batkay/CapstonePCB/nrfMain.step

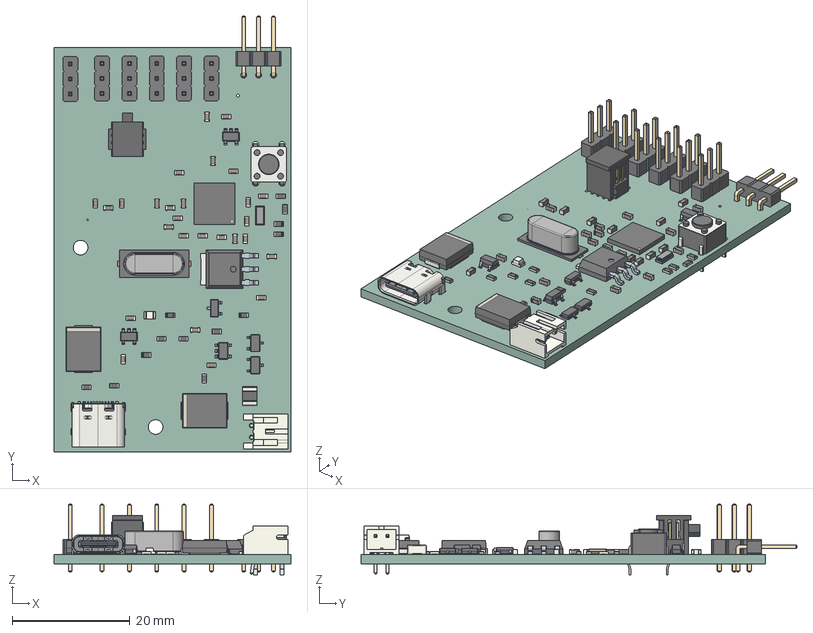
[picture p1: CAD file, 2025-03-10]
nrfMain.step
40.2 x 74.1 x 12.0 mm
R_0603_1608Metric x 13
Fuse_1210_3225Metric
PinHeader_1x03_P254mm_Vertical x 6
C_0603_1608Metric x 25
L_0603_1608Metric x 2
USB_C_Receptacle_16P_TopMnt_Horizontal_GCT_USB4105-xx-A
SOT_23_5 x 3
SW_PUSH_6mm
CQ assembly
SOT_23
TSOT_23 x 2
LED_0805_2012Metric
D_SMC x 2
Crystal_SMD_HC49-SD
FTSH-105-01-F-DV-K-P-TR
Nordic_AQFN-73-1EP_7x7mm_P0.5mm
JST_S2B_PH_K
Crystal_SMD_3215-2Pin_3.2x1.5mm
PinHeader_1x03_P254mm_Horizontal
nrfMain_PCB
