batkay/CapstonePCB/nrfMain.kicad_pcb

## KiCad design nrfMain.kicad_pcb (2025-03-14)

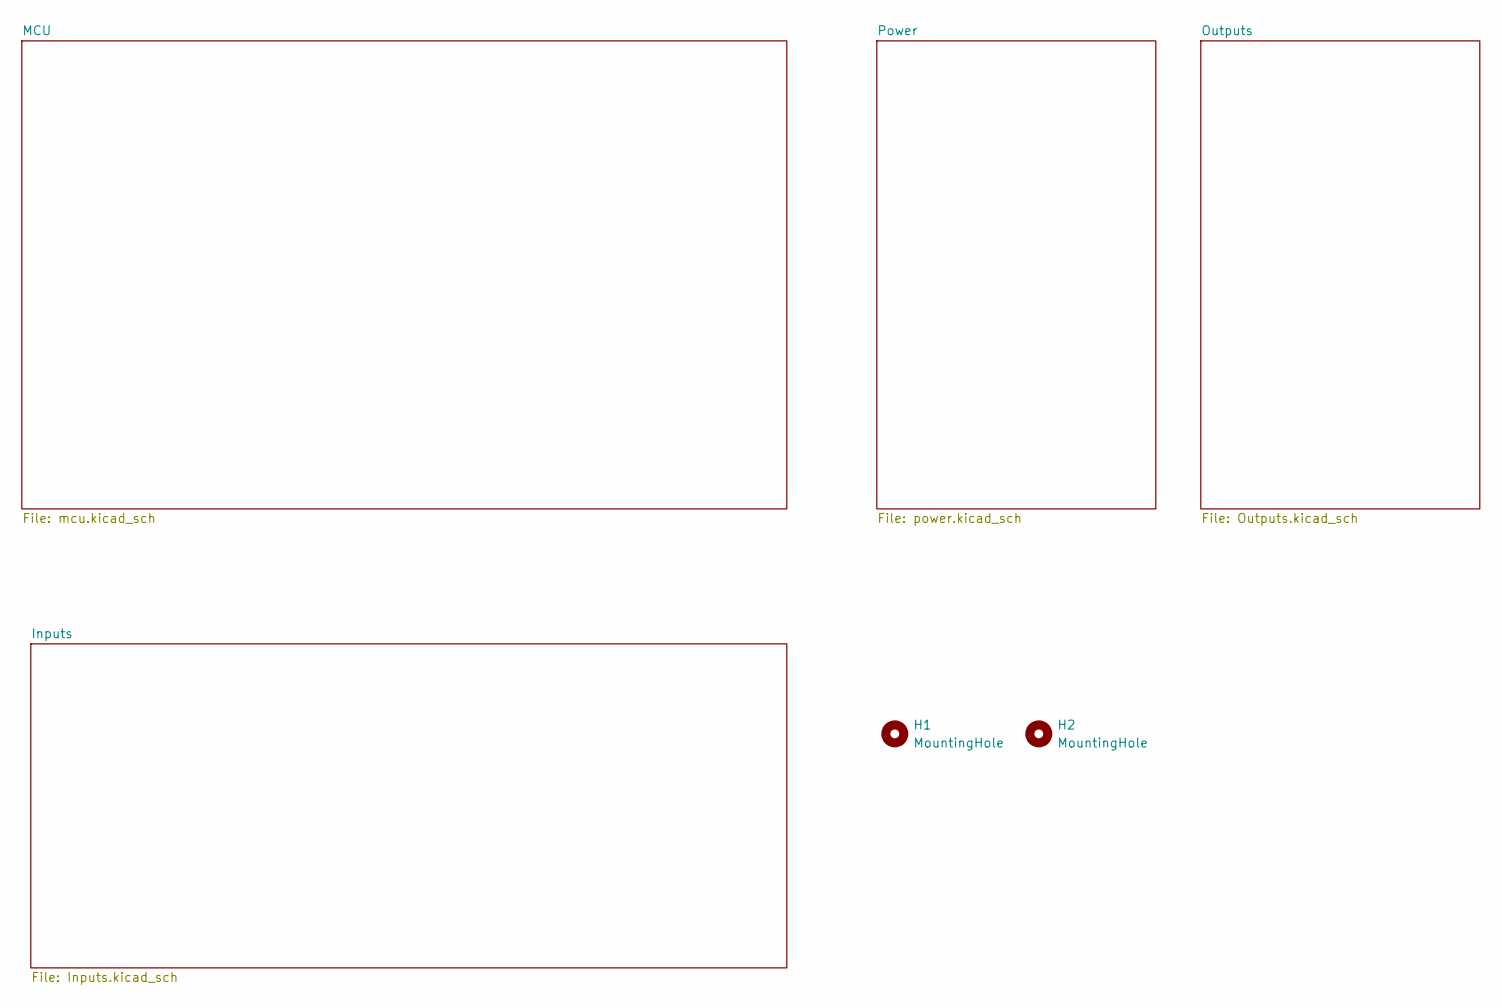
[picture p2: schematic nrfMain.kicad_sch]

Parts:
H1, H2: MountingHole; MountingHole_2.5mm

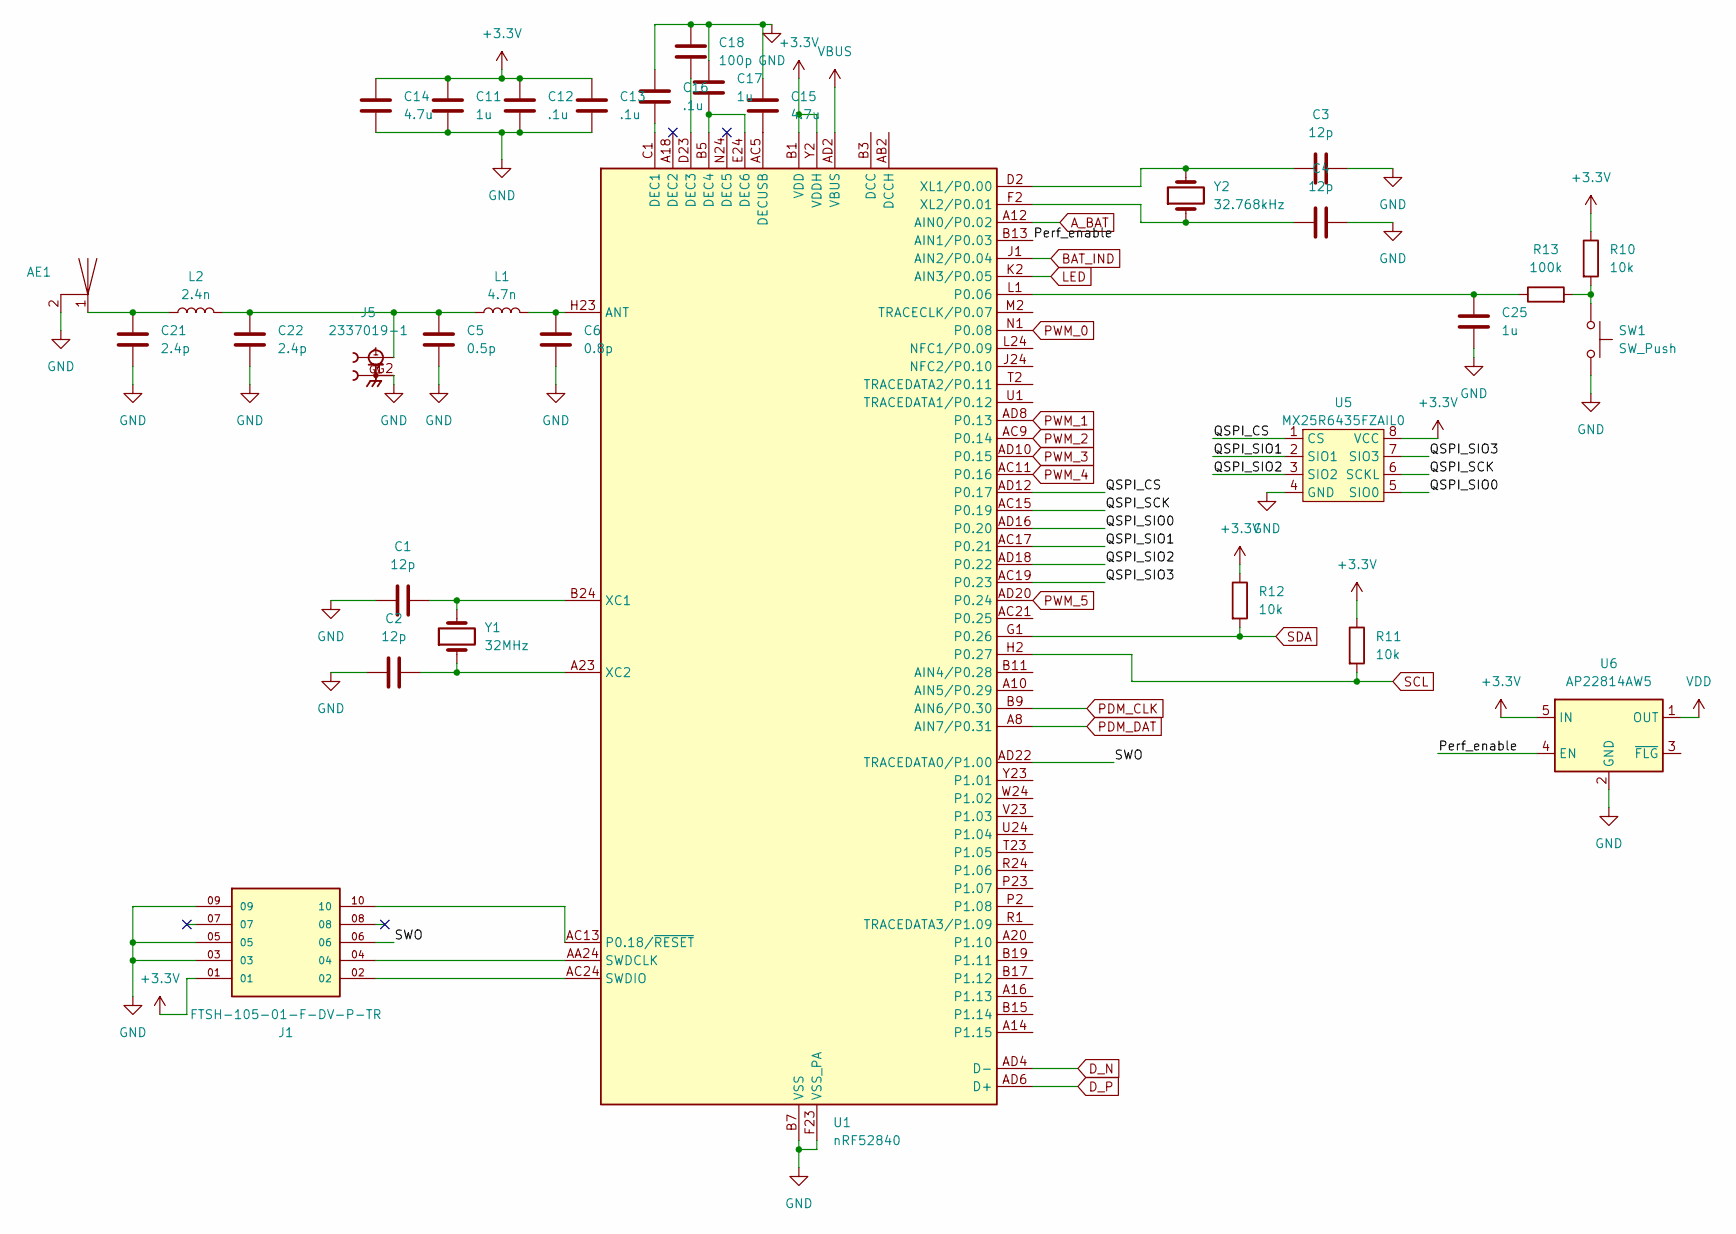
[picture p3: schematic mcu.kicad_sch]

Parts:
AE1: Trace Antenna
C1, C2, C3, C4: 12p; C_0603_1608Metric; MPN C107034; LCSC PN C107034
C5: 0.5p; C_0603_1608Metric; MPN C162254; LCSC PN C162254
C6: 0.8p; C_0603_1608Metric; MPN C907996; LCSC PN C907996
C11, C17, C25: 1u; C_0603_1608Metric; MPN C15849; LCSC PN C15849
C12, C13, C16: .1u; C_0603_1608Metric; MPN C14663; LCSC PN C14663
C14, C15: 4.7u; C_0603_1608Metric; MPN C19666; LCSC PN C19666
C18: 100p; C_0603_1608Metric; MPN C14665; LCSC PN C14665
C21, C22: 2.4p; C_0603_1608Metric; MPN C710896; LCSC PN C710896
J1: FTSH-105-01-F-DV-P-TR; SAMTEC_FTSH-105-01-F-DV-P-TR; PARTREV R; LCSC PN C5136979
J5: 2337019-1; TE_2337019-1; PARTREV A4
L1: 4.7n; L_0603_1608Metric; MPN C98078; LCSC PN C98078
L2: 2.4n; L_0603_1608Metric; MPN C2042508; LCSC PN C2042508
R10, R11, R12: 10k; R_0603_1608Metric; MPN C98220; LCSC PN C98220
R13: 100k; R_0603_1608Metric; MPN C14675; LCSC PN C14675
SW1: SW_Push; SW_PUSH_6mm; LCSC PN C393938
U1: nRF52840; Nordic_AQFN-73-1EP_7x7mm_P0.5mm; Part Number NRF52840-QIAA-R; LCSC PN C190794
U5: MX25R6435FZAIL0; WSON-8-1EP_4x4mm_P0.8mm_EP1.98x3mm; Part Number MX25R6435FZAIL0; LCSC PN C2802847
U6: AP22814AW5; SOT-23-5; MPN C2680321; LCSC PN C2680321
Y1: 32MHz; Crystal_SMD_HC49-SD; Part Number HY32M49SSMDOB2R20; LCSC PN C5265796
Y2: 32.768kHz; Crystal_SMD_3215-2Pin_3.2x1.5mm; Part Number Q13FC13500004; LCSC PN C32346

Connections:
+3.3V: C11.1, C12.1, C13.1, C14.1, J1.01, R10.1, R11.1, R12.1, U1.A22 (VDD), U1.AD14 (VDD), U1.AD23 (VDD), U1.B1 (VDD), U1.W1 (VDD), U1.Y2 (VDDH), U5.8 (VCC), U6.5 (IN); also elsewhere on the board
/MCU/Perf_enable: U1.B13 (AIN1/P0.03), U6.4 (EN)
/MCU/QSPI_CS: U1.AD12 (P0.17), U5.1 (CS)
/MCU/QSPI_SCK: U1.AC15 (P0.19), U5.6 (SCKL)
/MCU/QSPI_SIO0: U1.AD16 (P0.20), U5.5 (SIO0)
/MCU/QSPI_SIO1: U1.AC17 (P0.21), U5.2 (SIO1)
/MCU/QSPI_SIO2: U1.AD18 (P0.22), U5.3 (SIO2)
/MCU/QSPI_SIO3: U1.AC19 (P0.23), U5.7 (SIO3)
/MCU/SWO: J1.06, U1.AD22 (TRACEDATA0/P1.00)
A_BAT: U1.A12 (AIN0/P0.02); also elsewhere on the board
BAT_IND: U1.J1 (AIN2/P0.04); also elsewhere on the board
D_N: U1.AD4 (D-); also elsewhere on the board
D_P: U1.AD6 (D+); also elsewhere on the board
GND: AE1.2, C1.1, C2.1, C3.2, C4.2, C5.2, C6.2, C11.2, C12.2, C13.2, C14.2, C15.2, C16.1, C17.1, C18.1, C21.2, C22.2, C25.2, J1.03, J1.05, J1.09, J5.G1, J5.G2, SW1.2, U1.B7 (VSS), U1.EP (VSS), U1.F23 (VSS_PA), U5.4 (GND), U6.2 (GND); also elsewhere on the board
LED: U1.K2 (AIN3/P0.05); also elsewhere on the board
unnamed: AE1.1, C21.1, L2.1
unnamed: C5.1, C22.1, J5.1, L1.1, L2.2
unnamed: R10.2, R13.2, SW1.1
unnamed: C6.1, L1.2, U1.H23 (ANT)
unnamed: C16.2, U1.C1 (DEC1)
unnamed: C18.2, U1.D23 (DEC3)
unnamed: C17.2, U1.B5 (DEC4), U1.E24 (DEC6)
unnamed: C15.1, U1.AC5 (DECUSB)
unnamed: C25.1, R13.1, U1.L1 (P0.06)
unnamed: J1.10, U1.AC13 (P0.18/~RESET)
unnamed: J1.04, U1.AA24 (SWDCLK)
unnamed: J1.02, U1.AC24 (SWDIO)
unnamed: C1.2, U1.B24 (XC1), Y1.2
unnamed: C2.2, U1.A23 (XC2), Y1.1
unnamed: C3.1, U1.D2 (XL1/P0.00), Y2.2
unnamed: C4.1, U1.F2 (XL2/P0.01), Y2.1
PDM_CLK: U1.B9 (AIN6/P0.30); also elsewhere on the board
PDM_DAT: U1.A8 (AIN7/P0.31); also elsewhere on the board
PWM_0: U1.N1 (P0.08); also elsewhere on the board
PWM_1: U1.AD8 (P0.13); also elsewhere on the board
PWM_2: U1.AC9 (P0.14); also elsewhere on the board
PWM_3: U1.AD10 (P0.15); also elsewhere on the board
PWM_4: U1.AC11 (P0.16); also elsewhere on the board
PWM_5: U1.AD20 (P0.24); also elsewhere on the board
SCL: R11.2, U1.H2 (P0.27); also elsewhere on the board
SDA: R12.2, U1.G1 (P0.26); also elsewhere on the board
VBUS: U1.AD2 (VBUS); also elsewhere on the board
VDD: U6.1 (OUT); also elsewhere on the board

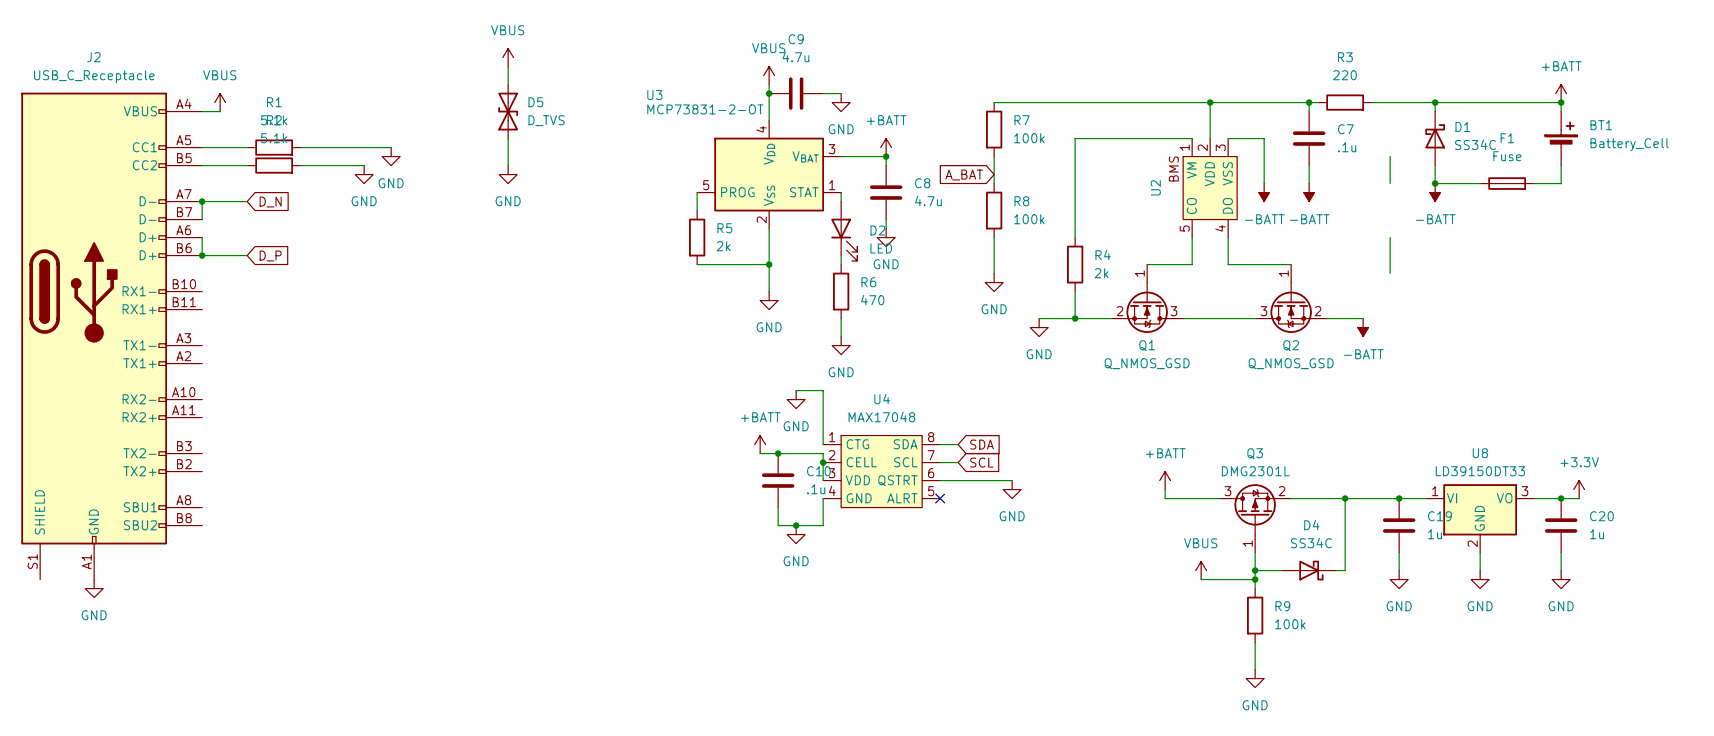
[picture p4: schematic power.kicad_sch]

Parts:
BT1: Battery_Cell; JST_PH_S2B-PH-K_1x02_P2.00mm_Horizontal; Part Number S2B-PH-K-S-GW; LCSC PN C157932
C7, C10: .1u; C_0603_1608Metric; MPN C14663; LCSC PN C14663
C8, C9: 4.7u; C_0603_1608Metric; MPN C19666; LCSC PN C19666
C19, C20: 1u; C_0603_1608Metric; MPN C15849; LCSC PN C15849
D1, D4: SS34C; D_SMC; MPN C13763; LCSC PN C13763
D2: LED; LED_0805_2012Metric; MPN C965817; LCSC PN C965817
D5: D_TVS; D_0402_1005Metric; Part Number TPD1E10B06DPYR; LCSC PN C48260
F1: Fuse; Fuse_1210_3225Metric; Part Number Shenzhen JDT Fuse ASMD1210-075; LCSC PN C135349
J2: USB_C_Receptacle; USB_C_Receptacle_GCT_USB4105-xx-A_16P_TopMnt_Horizontal; Part Number MC-107D; LCSC PN C2874568
Q1, Q2: Q_NMOS_GSD; TSOT-23; Part Number DMG3414U-7; LCSC PN C260927
Q3: DMG2301L; SOT-23; MPN C102619; LCSC PN C102619
R1, R2: 5.1k; R_0603_1608Metric; MPN C122969; LCSC PN C122969
R3: 220; R_0603_1608Metric; MPN C107696; LCSC PN C107696
R4, R5: 2k; R_0603_1608Metric; MPN C105576; LCSC PN C105576
R6: 470; R_0603_1608Metric; MPN C114669; LCSC PN C114669
R7, R8: 100k; R_0603_1608Metric; MPN C19666; LCSC PN C14675
R9: 100k; R_0603_1608Metric; MPN C14675; LCSC PN C14675
U2: SOT-23-5; Part Number S-8211CAZ-M5T1G; LCSC PN C5881307
U3: MCP73831-2-OT; SOT-23-5; Part Number MCP73831T-2ACI/OT; LCSC PN C424093
U4: MAX17048; TDFN-8-1EP_2x2mm_P0.5mm_EP0.8x1.2mm; MPN C2682616; LCSC PN C2682616
U8: LD39150DT33; TO-252-3_TabPin2; MPN C155559; LCSC PN C155559

Connections:
+3.3V: C20.1, U8.3 (VO); also elsewhere on the board
+BATT: BT1.1 (+), C8.1, C10.1, D1.1 (K), Q3.3 (D), R3.2, U3.3 (V_{BAT}), U4.2 (CELL), U4.3 (VDD)
-BATT: C7.2, D1.2 (A), F1.1, Q2.2 (S), U2.3 (VSS)
A_BAT: R7.2, R8.1; also elsewhere on the board
D_N: J2.A7 (D-), J2.B7 (D-); also elsewhere on the board
D_P: J2.A6 (D+), J2.B6 (D+); also elsewhere on the board
GND: C8.2, C9.2, C10.2, C19.2, C20.2, D5.1 (A1), J2.A1 (GND), J2.A12 (GND), J2.B1 (GND), J2.B12 (GND), Q1.2 (S), R1.2, R2.2, R4.1, R5.2, R6.2, R8.2, R9.2, U3.2 (V_{SS}), U4.1 (CTG), U4.4 (GND), U4.6 (QSTRT), U8.2 (GND); also elsewhere on the board
unnamed: BT1.2 (-), F1.2
unnamed: D2.2 (A), U3.1 (STAT)
unnamed: D2.1 (K), R6.1
unnamed: C19.1, D4.1 (K), Q3.2 (S), U8.1 (VI)
unnamed: J2.A5 (CC1), R1.1
unnamed: J2.B5 (CC2), R2.1
unnamed: Q1.3 (D), Q2.3 (D)
unnamed: Q1.1 (G), U2.5 (CO)
unnamed: Q2.1 (G), U2.4 (DO)
unnamed: C7.1, R3.1, R7.1, U2.2 (VDD)
unnamed: R4.2, U2.1 (VM)
unnamed: R5.1, U3.5 (PROG)
SCL: U4.7 (SCL); also elsewhere on the board
SDA: U4.8 (SDA); also elsewhere on the board
VBUS: C9.1, D4.2 (A), D5.2 (A2), J2.A4 (VBUS), J2.A9 (VBUS), J2.B4 (VBUS), J2.B9 (VBUS), Q3.1 (G), R9.1, U3.4 (V_{DD}); also elsewhere on the board

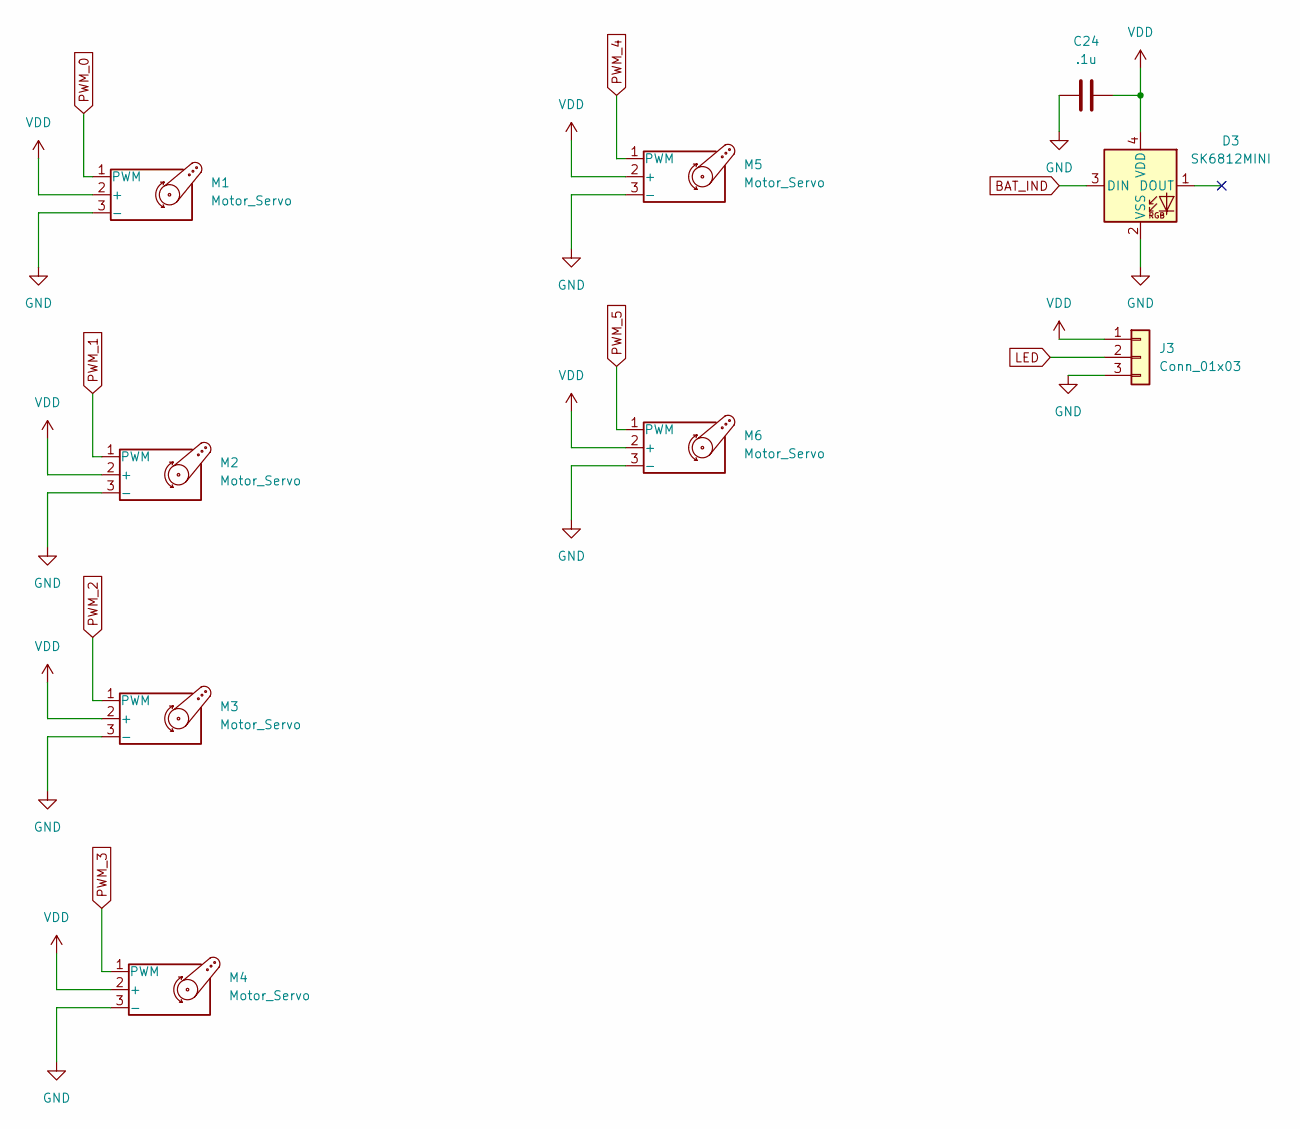
[picture p5: schematic Outputs.kicad_sch]

Parts:
C24: .1u; C_0603_1608Metric; MPN C14663; LCSC PN C14663
D3: SK6812MINI; LED_SK6812MINI_PLCC4_3.5x3.5mm_P1.75mm; MPN C2922787; LCSC PN C2922787
J3: Conn_01x03; PinHeader_1x03_P2.54mm_Horizontal
M1, M2, M3, M4, M5, M6: Motor_Servo; PinHeader_1x03_P2.54mm_Vertical

Connections:
BAT_IND: D3.3 (DIN); also elsewhere on the board
GND: C24.1, D3.2 (VSS), J3.3, M1.3 (-), M2.3 (-), M3.3 (-), M4.3 (-), M5.3 (-), M6.3 (-); also elsewhere on the board
LED: J3.2; also elsewhere on the board
PWM_0: M1.1 (PWM); also elsewhere on the board
PWM_1: M2.1 (PWM); also elsewhere on the board
PWM_2: M3.1 (PWM); also elsewhere on the board
PWM_3: M4.1 (PWM); also elsewhere on the board
PWM_4: M5.1 (PWM); also elsewhere on the board
PWM_5: M6.1 (PWM); also elsewhere on the board
VDD: C24.2, D3.4 (VDD), J3.1, M1.2 (+), M2.2 (+), M3.2 (+), M4.2 (+), M5.2 (+), M6.2 (+); also elsewhere on the board

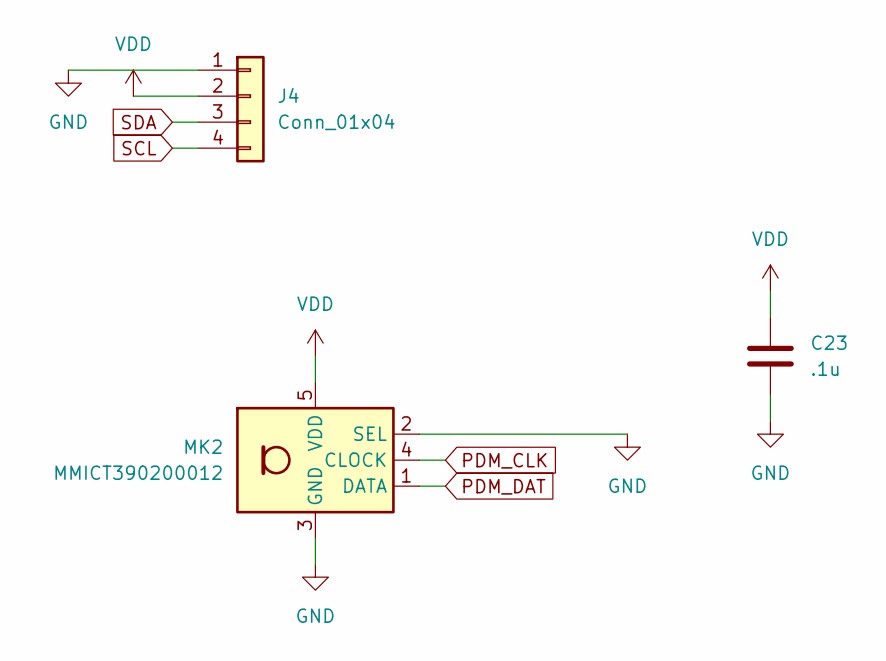
[picture p6: schematic Inputs.kicad_sch]

Parts:
C23: .1u; C_0603_1608Metric; MPN C14663; LCSC PN C14663
J4: Conn_01x04; JST_SH_BM04B-SRSS-TB_1x04-1MP_P1.00mm_Vertical; Part Number JST BM04B-SRSS-TB(LF)(SN); LCSC PN C160390
MK2: MMICT390200012; Knowles_LGA-5_3.5x2.65mm; Part Number MMICT390200012; LCSC PN C3171752

Connections:
GND: C23.2, J4.1, MK2.2 (SEL), MK2.3 (GND); also elsewhere on the board
PDM_CLK: MK2.4 (CLOCK); also elsewhere on the board
PDM_DAT: MK2.1 (DATA); also elsewhere on the board
SCL: J4.4; also elsewhere on the board
SDA: J4.3; also elsewhere on the board
VDD: C23.1, J4.2, MK2.5 (VDD); also elsewhere on the board

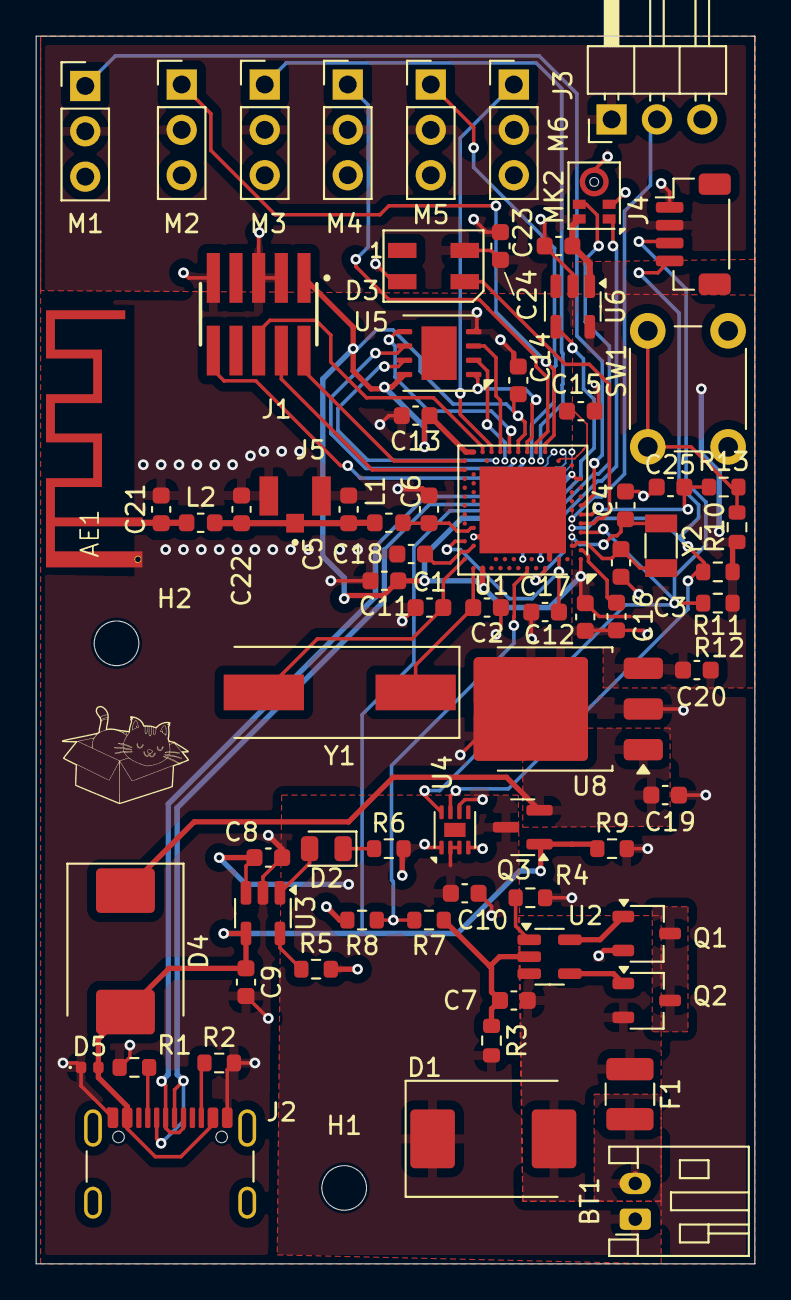
[picture p7: board nrfMain.kicad_pcb from above]

Board: 4 copper layers, 40.2 x 68.8 mm, 75 parts (0 on the bottom side), 57 nets.
