batkay/CapstonePCB/(commit log)

2025-02-05 Added antenna
    [mcu.kicad_sch, nrfMain.kicad_pcb, nrfMain.kicad_sch, power.kicad_sch]
2025-02-05 Setup charging
    [mcu.kicad_sch, nrfMain.kicad_pcb, power.kicad_sch]
2025-02-16 Added outputs page
    [Outputs.kicad_sch, mcu.kicad_sch, nrfMain.kicad_sch, power.kicad_sch]
2025-02-27 Added output headers
    [Inputs.kicad_sch, Outputs.kicad_sch, mcu.kicad_sch, nrfMain.kicad_pcb, nrfMain.kicad_sch, power.kicad_sch]
2025-02-27 Added pmos and regulator
    [power.kicad_sch]
2025-02-27 Switch regulator to 1.5A
    [power.kicad_sch]
2025-03-01 Added impedance match, gitignore
    [mcu.kicad_sch, nrfMain.kicad_pcb]
2025-03-01 Added TVS diode
    [power.kicad_sch]
2025-03-03 Added microphone, fuse
    [Inputs.kicad_sch, Outputs.kicad_sch, mcu.kicad_sch, power.kicad_sch]
2025-03-06 finished schematic
    [Inputs.kicad_sch, mcu.kicad_sch, nrfMain.kicad_pcb, power.kicad_sch]
2025-03-06 PCB layout
    [Outputs.kicad_sch, mcu.kicad_sch, nrfMain.kicad_pcb, power.kicad_sch]
2025-03-07 Added USB routing
    [nrfMain.kicad_pcb]
2025-03-07 Added LCSC PN for bms
    [power.kicad_sch]
2025-03-09 Added mounting holes and other final touches
    [mcu.kicad_sch, nrfMain.kicad_pcb, nrfMain.kicad_sch]
2025-03-10 step file
    [nrfMain.step]
2025-03-14 Made modifications from fabrication
    [Inputs.kicad_sch, Outputs.kicad_sch, mcu.kicad_sch, nrfMain.kicad_pcb, power.kicad_sch]
